paramworks-git/param-key/hardware/pinout.md

# Pinout

ESP32-S3-MINI-1 GPIO assignments. GPIO0-21 can wake the remote from deep sleep.

| GPIO | Function |
|---|---|
| 0 | key: home |
| 1 | VBUS_SENSE |
| 2 | key: power |
| 3 | key: ok |
| 4 | key: up |
| 5 | key: down |
| 6 | key: left |
| 7 | key: right |
| 8 | key: back |
| 9 | key: vol_up |
| 10 | key: vol_down |
| 11 | key: mute |
| 12 | key: play |
| 13 | key: rew |
| 14 | key: fwd |
| 15 | key: h1 |
| 16 | key: h2 |
| 17 | key: h3 |
| 18 | key: h4 |
| 19 | USB_DN |
| 20 | USB_DP |
| 21 | ACC_INT |
| 26 | (free) |
| 33 | LCD_SCK |
| 34 | LCD_MOSI |
| 35 | LCD_CS |
| 36 | LCD_DC |
| 37 | IR_RX |
| 38 | LCD_PWR_EN |
| 39 | I2C_SDA |
| 40 | I2C_SCL |
| 41 | CHRG |
| 42 | MIC_SCK |
| 43 | key: settings |
| 44 | key: stop |
| 45 | BL_PWM |
| 46 | IR_PWM |
| 47 | MIC_WS |
| 48 | MIC_SD |
