paramworks-git/param-key/hardware/case/back.png

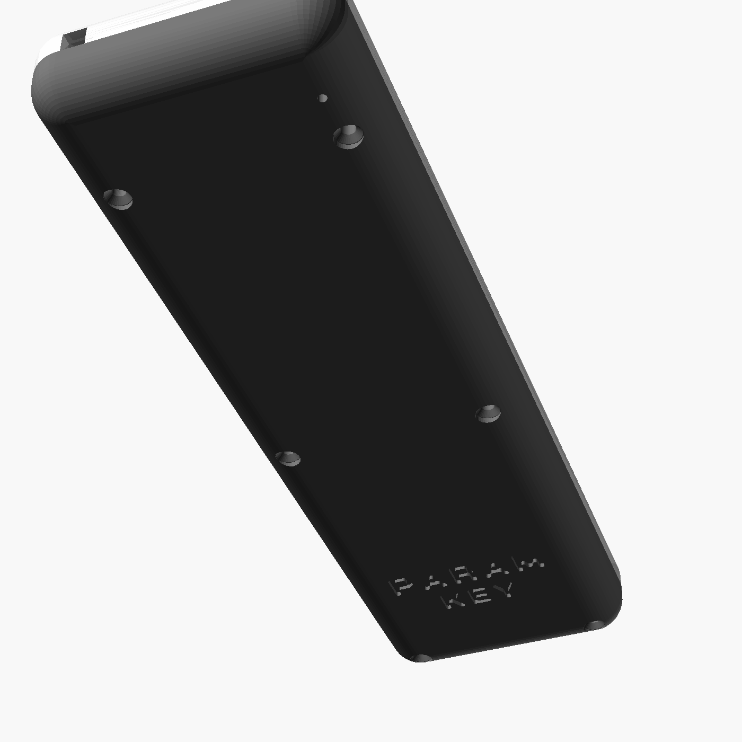
hardware/case/back.png
