paramworks-git/param-key/hardware/case/exploded.png

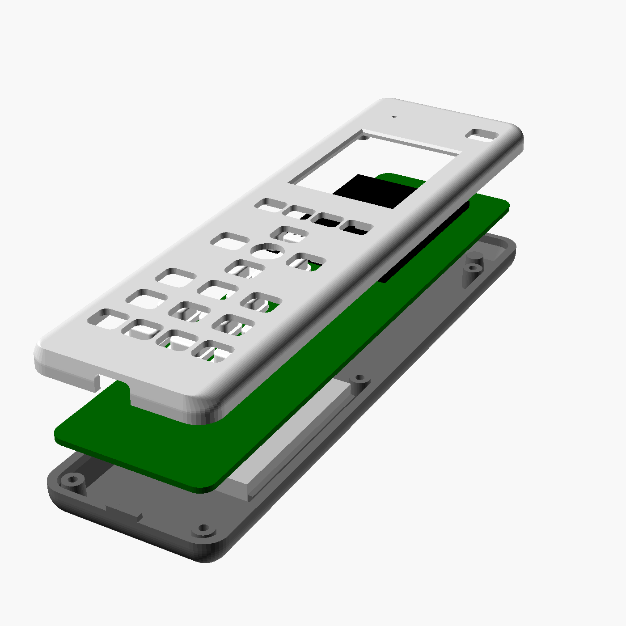
hardware/case/exploded.png
