paramworks-git/param-key/hardware/case/ir_end_grille.png

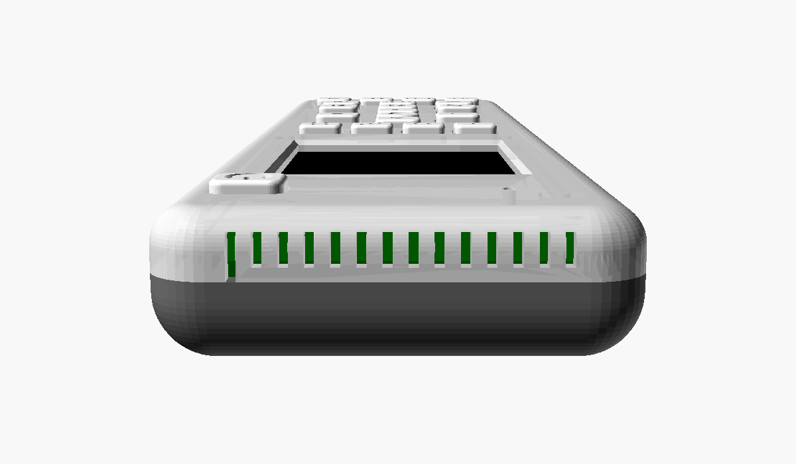
hardware/case/ir_end_grille.png
