paramworks-git/param-key/hardware/case/profile.png

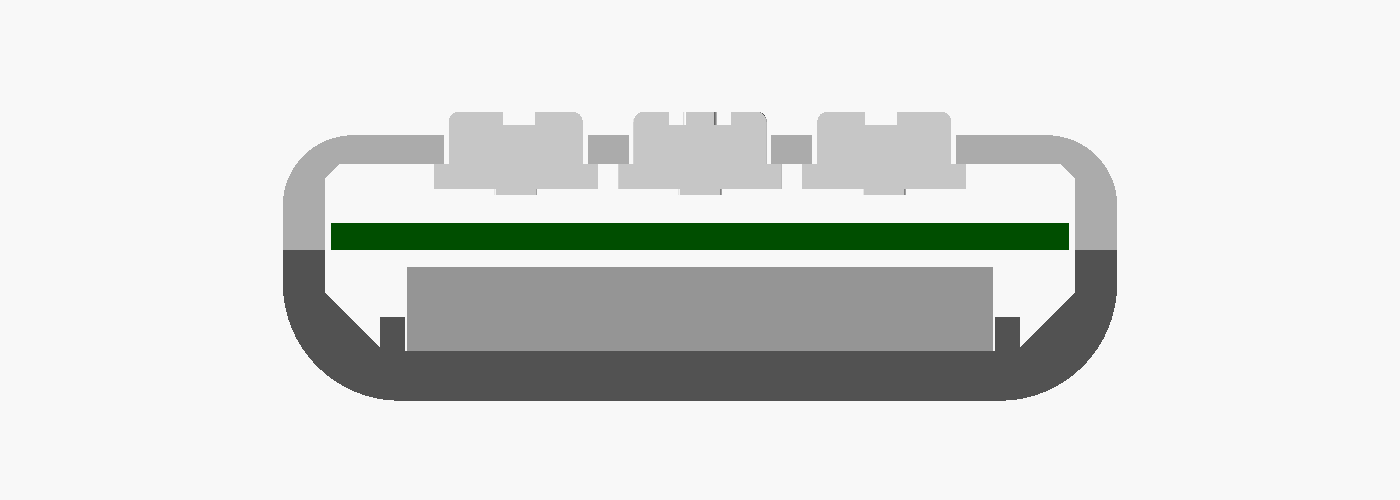
hardware/case/profile.png
