paramworks-git/param-key/hardware/fea/back_middle_of_the_back_50N.png

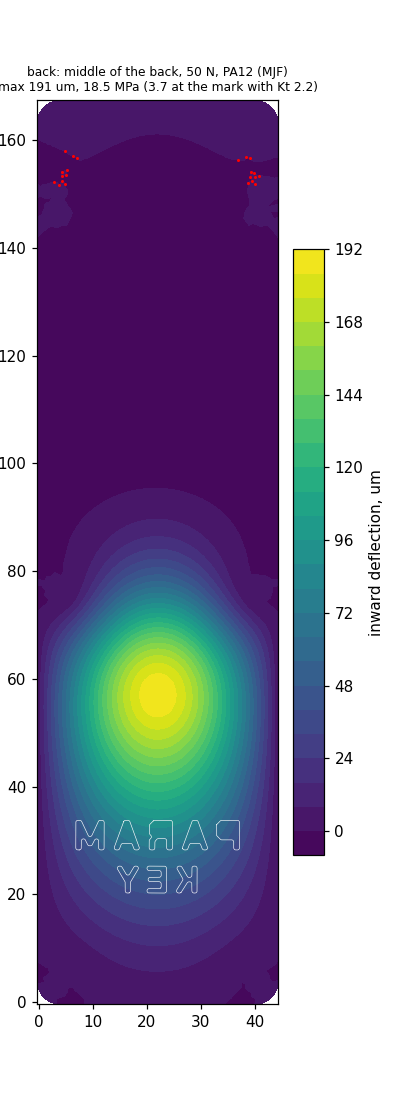
hardware/fea/back_middle_of_the_back_50N.png
