paramworks-git/param-key/hardware/fea/back_on_the_mark_10N.png

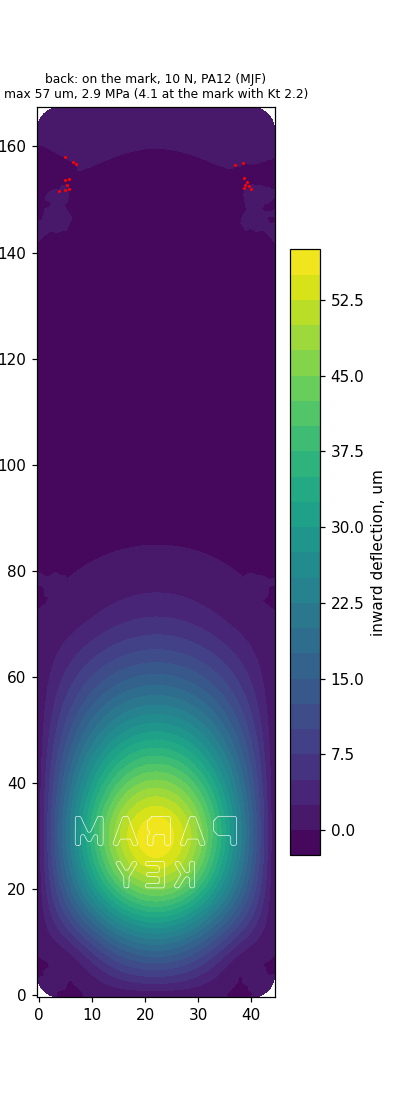
hardware/fea/back_on_the_mark_10N.png
