paramworks-git/param-key/hardware/fea/back_sat_on_300N.png

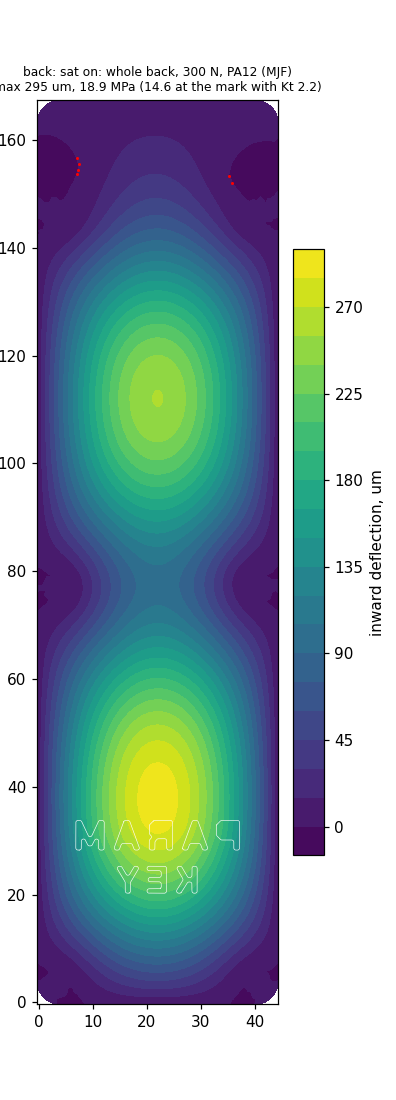
hardware/fea/back_sat_on_300N.png
