paramworks-git/param-key/hardware/fea/back_top_end_between_the_screw_pairs_50N.png

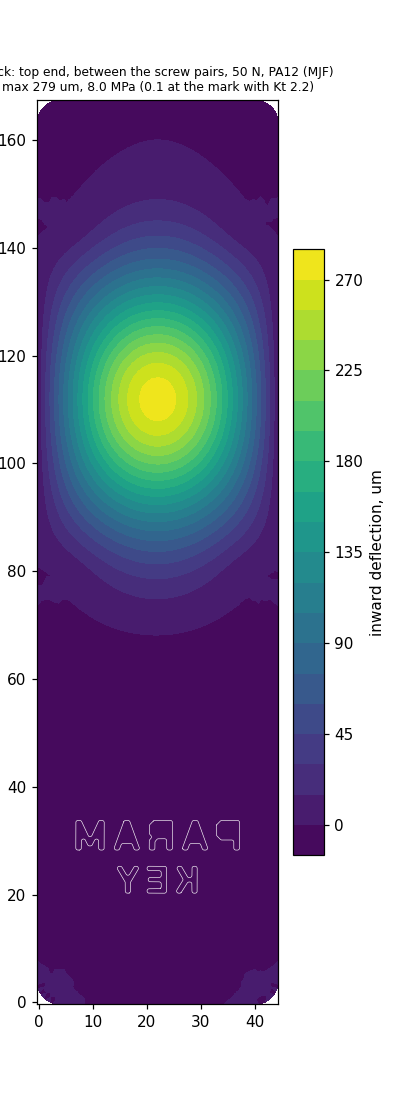
hardware/fea/back_top_end_between_the_screw_pairs_50N.png
