paramworks-git/param-key/hardware/fea/face_below_the_screen_10N.png

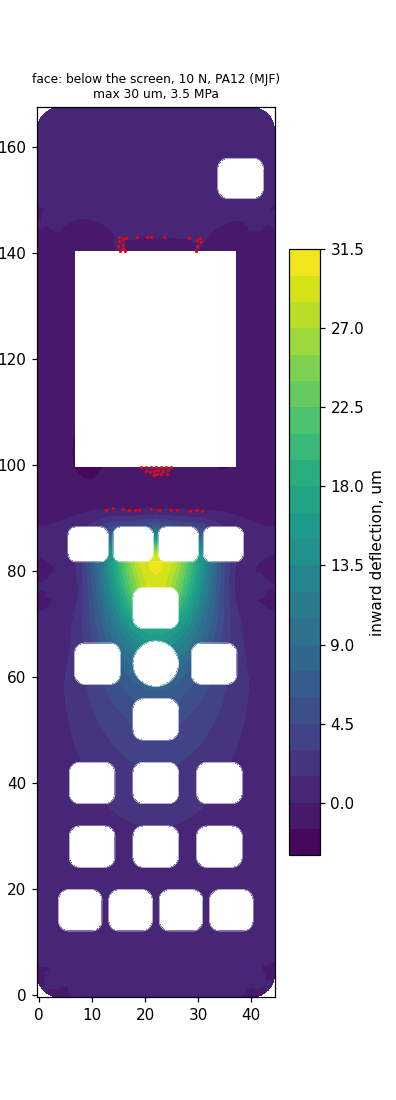
hardware/fea/face_below_the_screen_10N.png
