paramworks-git/param-key/hardware/fea/face_bottom_end_10N.png

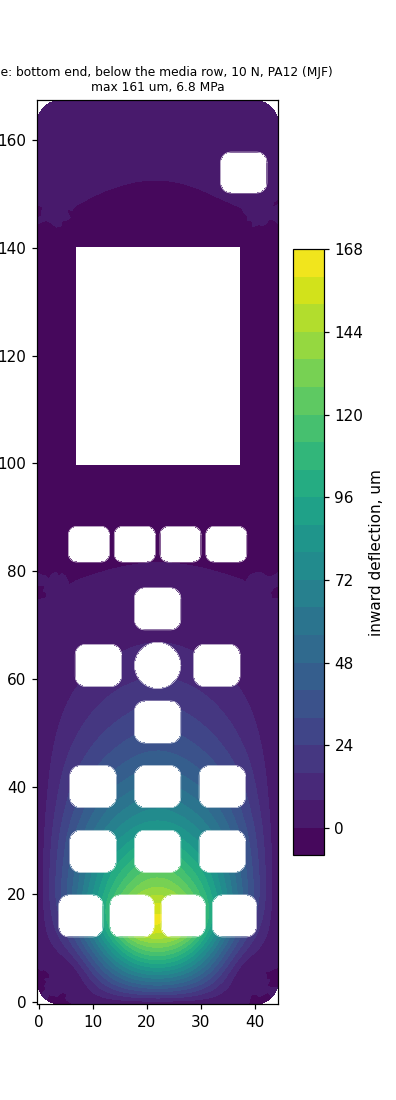
hardware/fea/face_bottom_end_10N.png
