paramworks-git/param-key/hardware/fea/face_top_end_50N.png

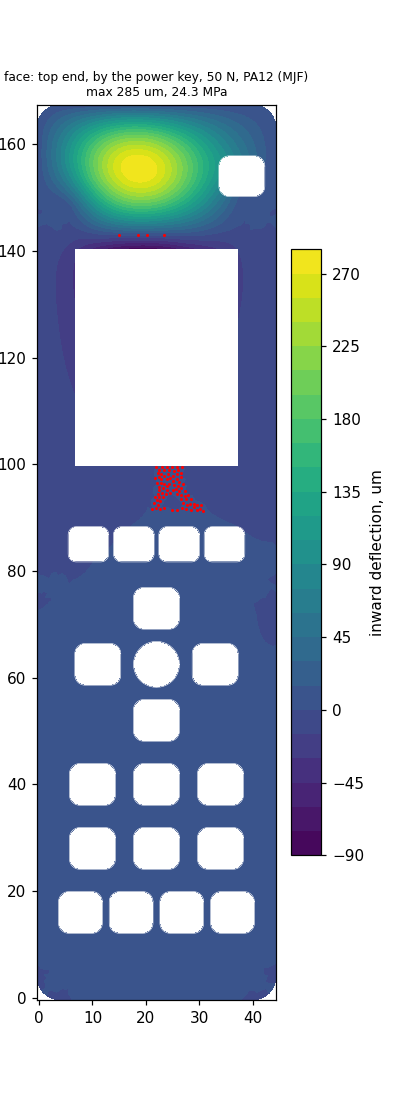
hardware/fea/face_top_end_50N.png
