paramworks-git/param-key/hardware/parts.md

# Parts

Function-level list: the active parts and connectors, and counts of the rest.

| Ref | Part |
|---|---|
| D1 | SFH 4045N 950nm |
| D2 | B5819W |
| D3 | SMF5.0A |
| J1 | TYPE-C-31-M-12 |
| J2 | LCD FPC 12P 0.5mm |
| J3 | LiPo (JST PH, 1=GND 2=+) |
| Q1 | AO3401A |
| Q2 | AO3400A |
| Q3 | AO3400A |
| Q4 | AO3401A |
| U1 | ESP32-S3-MINI-1-N4R2 |
| U2 | USBLC6-2SC6 |
| U3 | TP4054 |
| U4 | RT9080-33GJ5 |
| U5 | LIS2DH12TR |
| U7 | MAX17048 |
| U8 | TSOP75238TR |

Plus 21 tactile switches, 37 resistors and 15 capacitors, and 8 labelled test pads on the back.
