paramworks-git/param-key/hardware/case/top.stl

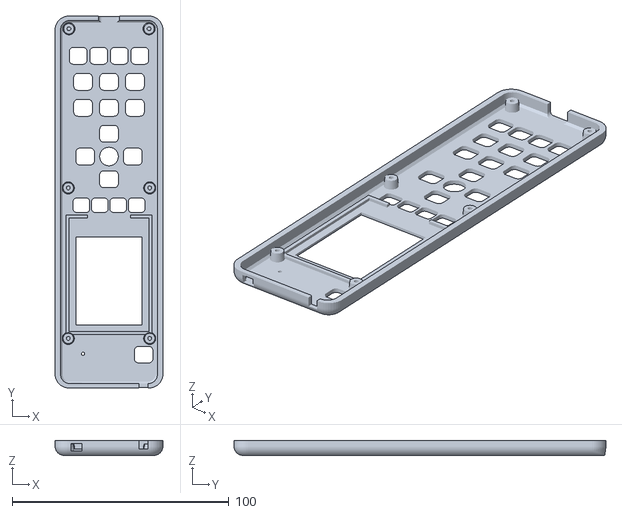
[picture p15: CAD file, 2026-11-13]
hardware/case/top.stl
49.8 x 171.8 x 6.85
