paramworks-git/param-key/hardware/case/caps_1.stl

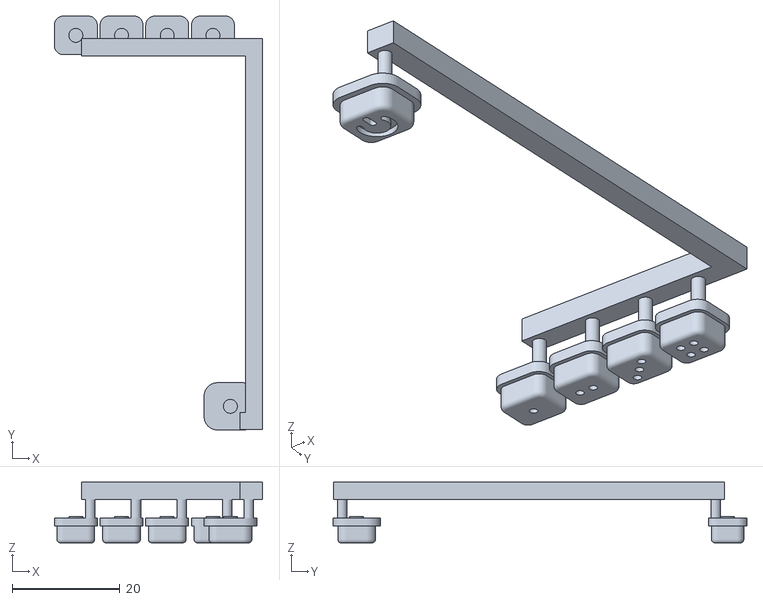
[picture p16: CAD file, 2026-11-01]
hardware/case/caps_1.stl
38.8 x 77.0 x 11.3
