paramworks-git/param-key/hardware/case/caps_3.stl

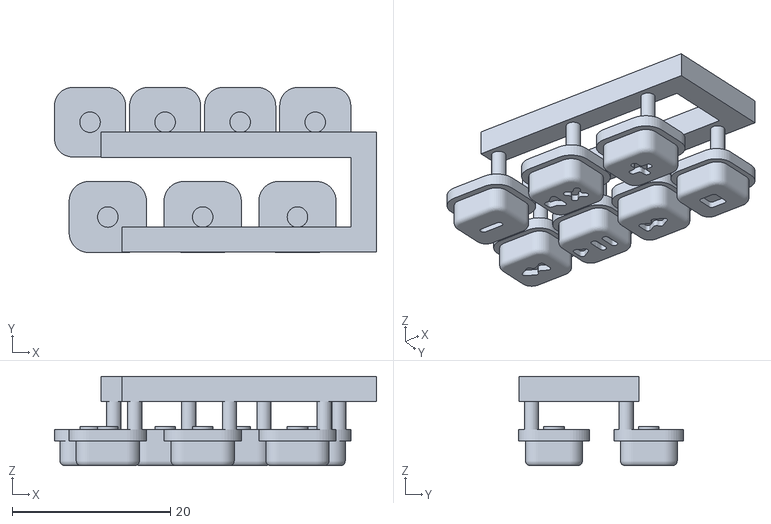
[picture p17: CAD file, 2026-11-01]
hardware/case/caps_3.stl
40.8 x 20.9 x 11.3
