paramworks-git/param-key/hardware/case/bottom.stl

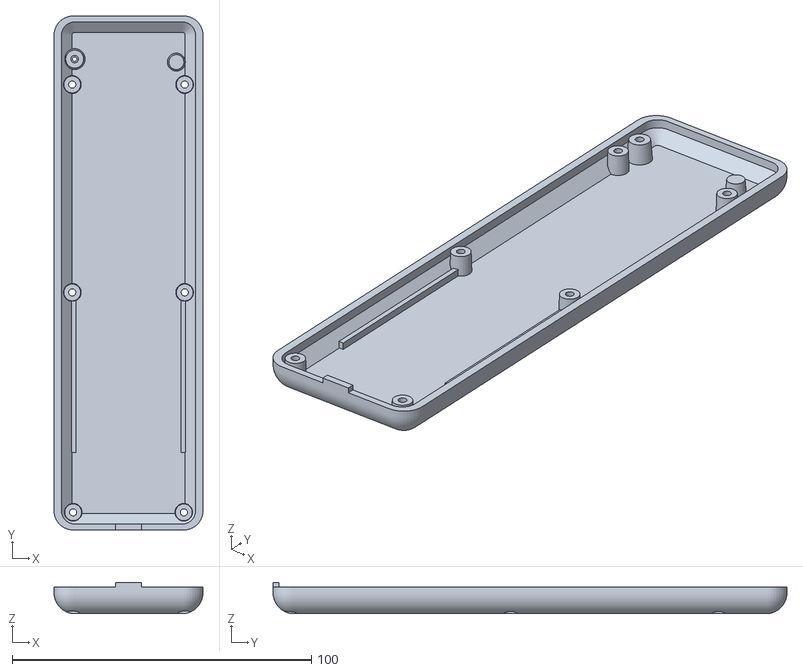
[picture p18: CAD file, 2026-11-01]
hardware/case/bottom.stl
49.8 x 171.8 x 10.5
