paramworks-git/param-key/hardware/case/caps_2.stl

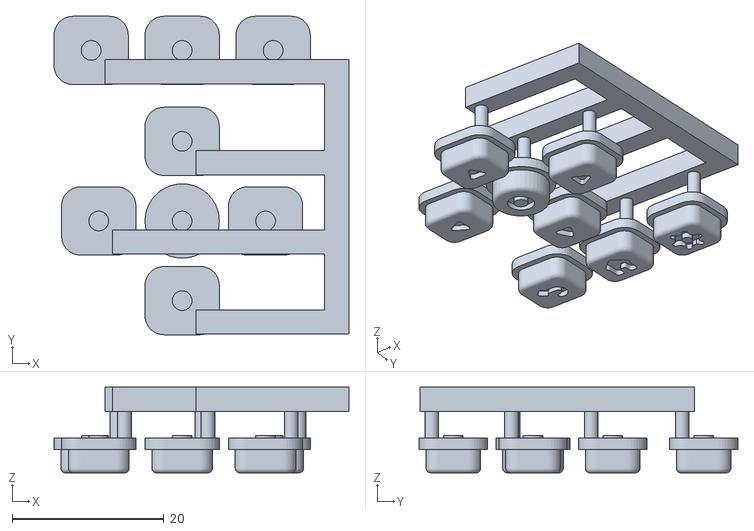
[picture p19: CAD file, 2026-11-01]
hardware/case/caps_2.stl
38.9 x 42.0 x 11.3
