paramworks-git/param-key/(list of files, cad)

Other CAD files:
hardware/case/top_grille.stl
