paramworks-git/param-key/hardware/schematic/param-key-schematic.pdf

100kA 1 | B 2 C 3 | D 4

# ok R27

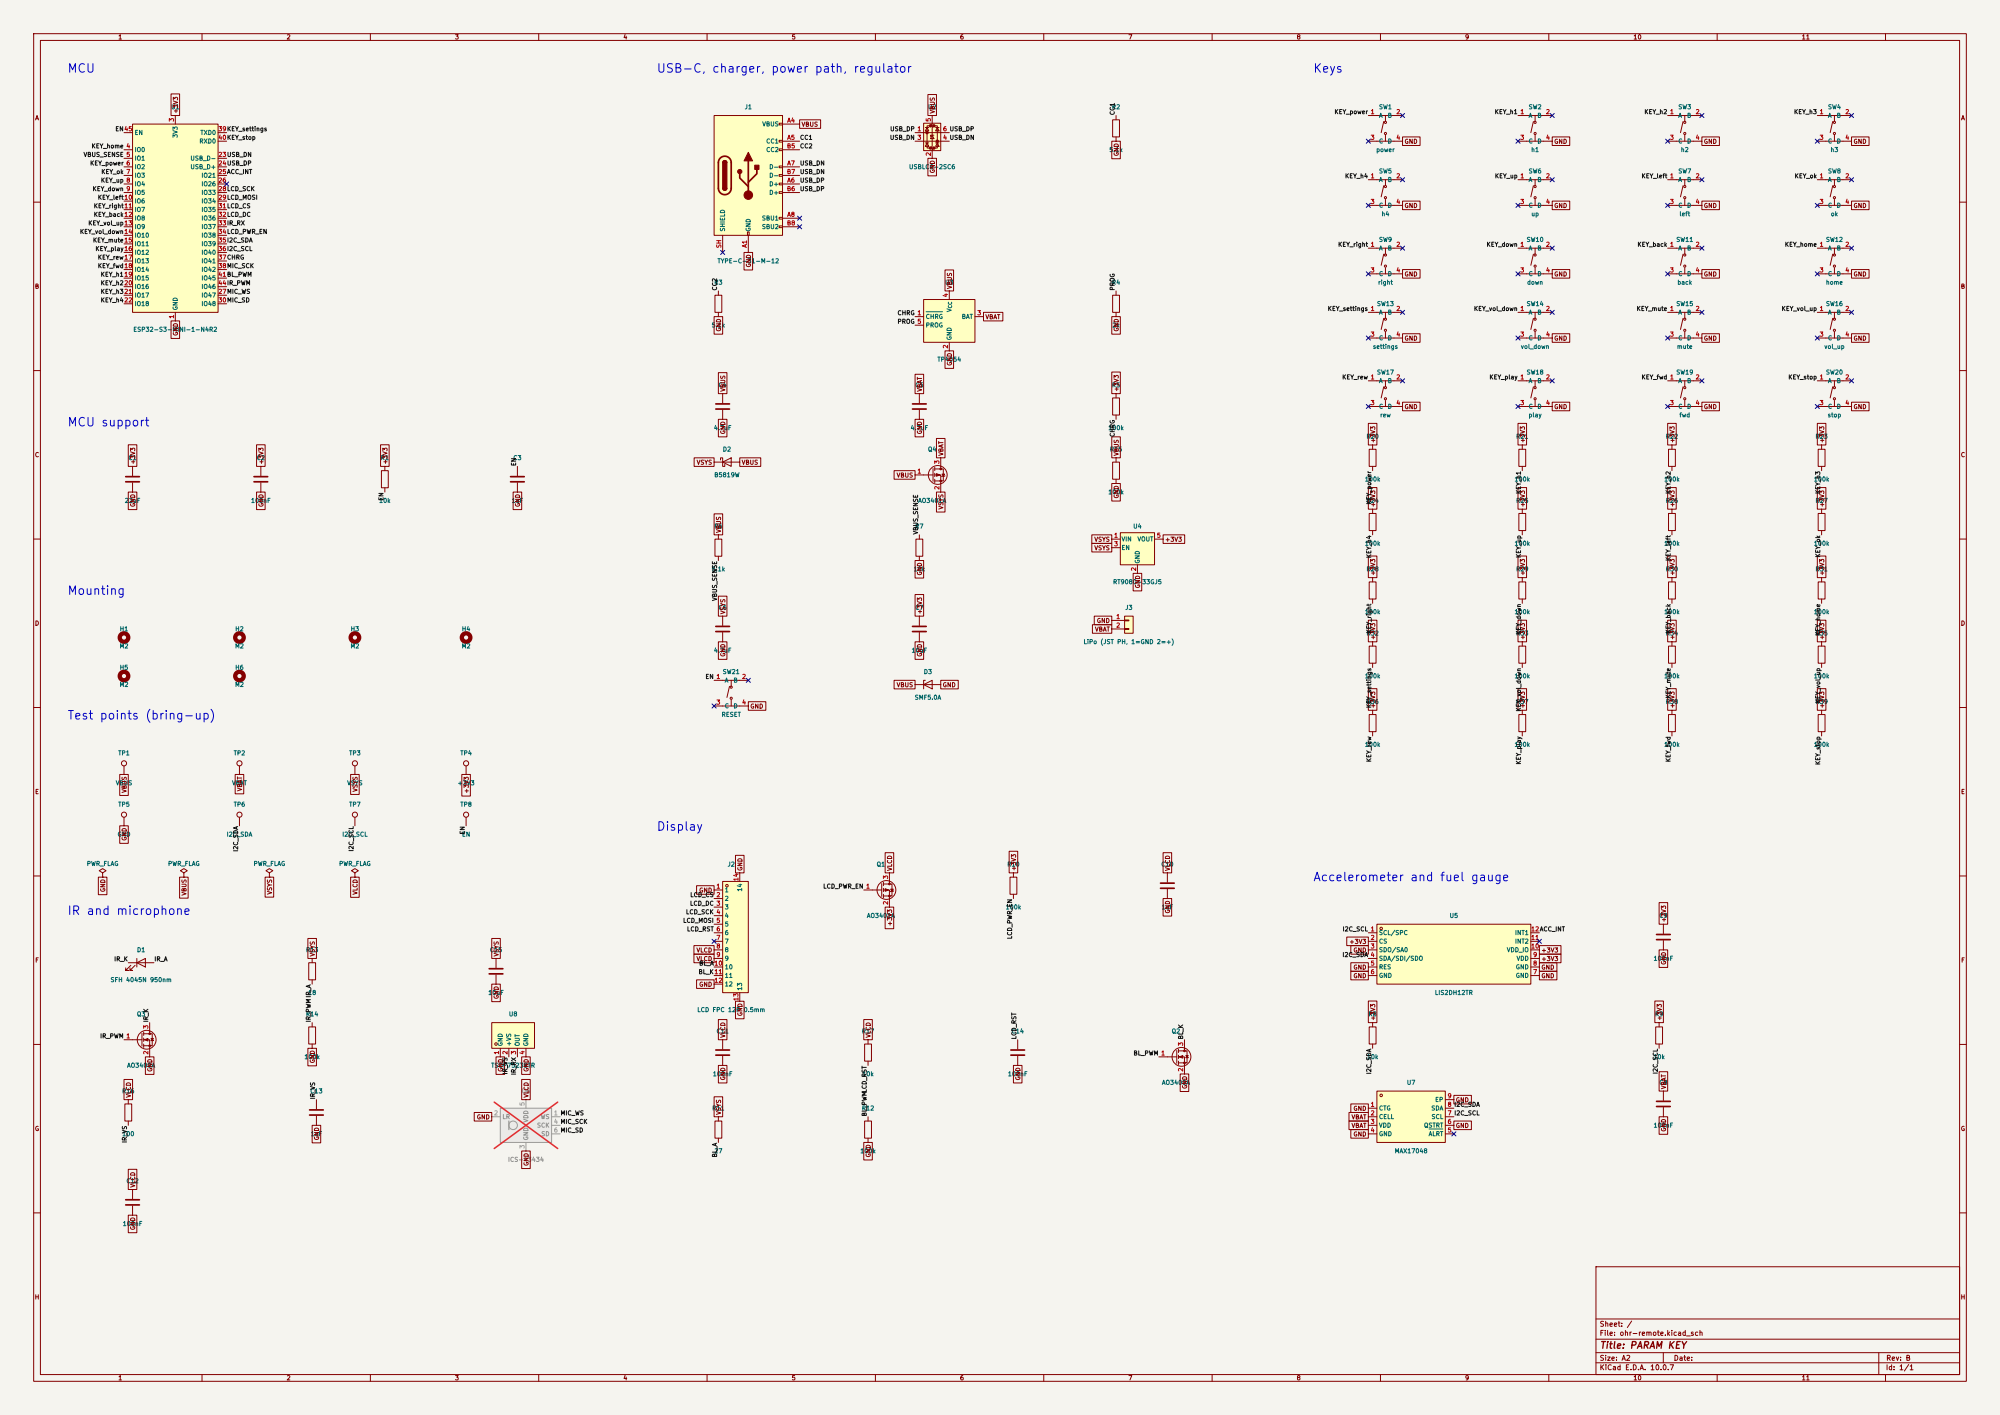
[picture p20: page 1]

Test points (bring-up)

Accelerometer and fuel gauge
