paramworks-git/param-key/(commit log)

2026-11-01 hardware: export from param-key-hardware 042135b4
    [bottom.stl, caps_1.stl, caps_2.stl, caps_3.stl, top.stl]
2026-11-01 Brand: PARAM KEY mark and logo (System 04-R, orange switch-plate datum) in README and installer; installer in brand colours; battery 2–3 weeks
2026-11-01 README: v1 and v2 side by side (battery gauge, charging, IR receiver), security, honest IR-learning status
2026-11-02 Bridge 0.3.1: 30 s http_request timeout so OTA updates survive read stalls; forum thread link
    [remote_core.yaml]
2026-11-02 README: wireless uploads from ESPHome Builder after Take control
2026-11-03 hardware: export from param-key-hardware (v2: VBUS sense on IO1 so USB wakes it, IR receiver on IO37; side-looking IR LED; grille top)
    [top.stl, top_grille.stl]
2026-11-03 README: beta list on paramworks.com; forum thread link
